alvislin/CortexM3_SoC/AHBlite_ACCC.v

//--------------------------------------------//
// Data   RAM         0   0x40030000          //
// ........                                   //
// Data   RAM         149 0x40030095          //
// STATE              REG 0x40030096          //
// NUM0                   0x40030097          //
// ........                                   //
// NUM0                   0x400300a0          //
//--------------------------------------------//
module AHBlite_ACCC (
    input   wire                        HCLK,    
    input   wire                        HRESETn, 
    input   wire                        HSEL,    
    input   wire    [31:0]              HADDR,   
    input   wire    [1:0]               HTRANS,  
    input   wire    [2:0]               HSIZE,   
    input   wire    [3:0]               HPROT,   
    input   wire                        HWRITE,  
    input   wire    [31:0]              HWDATA,   
    input   wire                        HREADY, 
    output  wire                        HREADYOUT, 
    output  wire    [31:0]              HRDATA,  
    output  wire    [1:0]               HRESP,

    input   wire    [5:0]               Data_RAM_RD_Addr,
    output  wire    [23:0]              Data_RAM_RD_Data,

    input   wire    [8:0]               Weight_RAM_RD_Addr,
    output  wire    [191:0]             Weight_RAM_RD_Data,

    input   wire    [7:0]               Num0,
    input   wire    [7:0]               Num1,
    input   wire    [7:0]               Num2,
    input   wire    [7:0]               Num3,
    input   wire    [7:0]               Num4,
    input   wire    [7:0]               Num5,
    input   wire    [7:0]               Num6,
    input   wire    [7:0]               Num7,
    input   wire    [7:0]               Num8,
    input   wire    [7:0]               Num9,

    output  wire                        ACC_VALID,
    input   wire                        ACC_READY
);

//--------------------------------------------------
// RAM
//--------------------------------------------------

reg     [5:0]   Data_RAM_WR_Addr;
wire    [7:0]   Data_RAM_WR_Data;
wire    [2:0]   Data_RAM_WE_T;

LocalRAM #(
    .ByteWidth      (3),
    .AddrWidth      (6)
)   Data_RAM(
    .clk        (HCLK),
    .din        (Data_RAM_WR_Data),
    .rdaddr     (Data_RAM_RD_Addr),
    .we         (Data_RAM_WE_T),
    .wraddr     (Data_RAM_WR_Addr),
    .dout       (Data_RAM_RD_Data)
);

LocalROM #(
    .ByteWidth      (24),
    .AddrWidth      (9)
)   Weight_RAM(
    .clk        (HCLK),
    .addr       (Weight_RAM_RD_Addr),
    .dout       (Weight_RAM_RD_Data)
);

//--------------------------------------------------
// AHB SIGNALS
//--------------------------------------------------

assign HRESP        = 2'b0;
assign HREADYOUT    = 1'b1;

wire trans_en;
assign trans_en     = HSEL & HTRANS[1] & HREADY;

wire write_en;
assign write_en     = trans_en & HWRITE;


reg wr_en_reg;
always@(posedge HCLK or negedge HRESETn) begin
  if(~HRESETn) 
    wr_en_reg <= 1'b0;
  else 
    wr_en_reg <= write_en;
end

reg [7:0] addr_reg;
always@(posedge HCLK or negedge HRESETn) begin
  if(~HRESETn) 
    addr_reg <= 4'b0;
  else if(trans_en) 
    addr_reg <= HADDR[7:0];
end

//--------------------------------------------------
// STATE CONTROL
//--------------------------------------------------

reg state;
wire state_nxt;

assign state_en     = wr_en_reg &   (addr_reg == 8'h96) & HWDATA[0];
assign state_nxt    = state     ?   (~ACC_READY)    :   state_en;

always@(posedge HCLK or negedge HRESETn) begin
  if(~HRESETn) 
    state <= 1'b0;
  else 
    state <= state_nxt;
end

assign  ACC_VALID   =   state;

//--------------------------------------------------
// DATA RAM CONTROL
//--------------------------------------------------

// assign  Data_RAM_WE         =   wr_en_reg   &   (addr_reg == 4'h0);
// assign  Data_RAM_WR_Addr    =   HWDATA[29:24];
assign  Data_RAM_WR_Data    =   HWDATA[7:0];

reg     [2:0]   Data_RAM_WE;

assign  Data_RAM_WE_T = wr_en_reg ? Data_RAM_WE : 3'h0;

always@(*) begin
  case(addr_reg)
    8'h00 : begin
      Data_RAM_WE = 3'h1;
      Data_RAM_WR_Addr = 6'h00;
    end 8'h1 : begin
      Data_RAM_WR_Addr = 6'h0;
      Data_RAM_WE = 3'h2;
    end 8'h2 : begin
      Data_RAM_WR_Addr = 6'h0;
      Data_RAM_WE = 3'h4;
    end 8'h3 : begin
      Data_RAM_WR_Addr = 6'h1;
      Data_RAM_WE = 3'h1;
    end 8'h4 : begin
      Data_RAM_WR_Addr = 6'h1;
      Data_RAM_WE = 3'h2;
    end 8'h5 : begin
      Data_RAM_WR_Addr = 6'h1;
      Data_RAM_WE = 3'h4;
    end 8'h6 : begin
      Data_RAM_WR_Addr = 6'h2;
      Data_RAM_WE = 3'h1;
    end 8'h7 : begin
      Data_RAM_WR_Addr = 6'h2;
      Data_RAM_WE = 3'h2;
    end 8'h8 : begin
      Data_RAM_WR_Addr = 6'h2;
      Data_RAM_WE = 3'h4;
    end 8'h9 : begin
      Data_RAM_WR_Addr = 6'h3;
      Data_RAM_WE = 3'h1;
    end 8'ha : begin
      Data_RAM_WR_Addr = 6'h3;
      Data_RAM_WE = 3'h2;
    end 8'hb : begin
      Data_RAM_WR_Addr = 6'h3;
      Data_RAM_WE = 3'h4;
    end 8'hc : begin
      Data_RAM_WR_Addr = 6'h4;
      Data_RAM_WE = 3'h1;
    end 8'hd : begin
      Data_RAM_WR_Addr = 6'h4;
      Data_RAM_WE = 3'h2;
    end 8'he : begin
      Data_RAM_WR_Addr = 6'h4;
      Data_RAM_WE = 3'h4;
    end 8'hf : begin
      Data_RAM_WR_Addr = 6'h5;
      Data_RAM_WE = 3'h1;
    end 8'h10 : begin
      Data_RAM_WR_Addr = 6'h5;
      Data_RAM_WE = 3'h2;
    end 8'h11 : begin
      Data_RAM_WR_Addr = 6'h5;
      Data_RAM_WE = 3'h4;
    end 8'h12 : begin
      Data_RAM_WR_Addr = 6'h6;
      Data_RAM_WE = 3'h1;
    end 8'h13 : begin
      Data_RAM_WR_Addr = 6'h6;
      Data_RAM_WE = 3'h2;
    end 8'h14 : begin
      Data_RAM_WR_Addr = 6'h6;
      Data_RAM_WE = 3'h4;
    end 8'h15 : begin
      Data_RAM_WR_Addr = 6'h7;
      Data_RAM_WE = 3'h1;
    end 8'h16 : begin
      Data_RAM_WR_Addr = 6'h7;
      Data_RAM_WE = 3'h2;
    end 8'h17 : begin
      Data_RAM_WR_Addr = 6'h7;
      Data_RAM_WE = 3'h4;
    end 8'h18 : begin
      Data_RAM_WR_Addr = 6'h8;
      Data_RAM_WE = 3'h1;
    end 8'h19 : begin
      Data_RAM_WR_Addr = 6'h8;
      Data_RAM_WE = 3'h2;
    end 8'h1a : begin
      Data_RAM_WR_Addr = 6'h8;
      Data_RAM_WE = 3'h4;
    end 8'h1b : begin
      Data_RAM_WR_Addr = 6'h9;
      Data_RAM_WE = 3'h1;
    end 8'h1c : begin
      Data_RAM_WR_Addr = 6'h9;
      Data_RAM_WE = 3'h2;
    end 8'h1d : begin
      Data_RAM_WR_Addr = 6'h9;
      Data_RAM_WE = 3'h4;
    end 8'h1e : begin
      Data_RAM_WR_Addr = 6'ha;
      Data_RAM_WE = 3'h1;
    end 8'h1f : begin
      Data_RAM_WR_Addr = 6'ha;
      Data_RAM_WE = 3'h2;
    end 8'h20 : begin
      Data_RAM_WR_Addr = 6'ha;
      Data_RAM_WE = 3'h4;
    end 8'h21 : begin
      Data_RAM_WR_Addr = 6'hb;
      Data_RAM_WE = 3'h1;
    end 8'h22 : begin
      Data_RAM_WR_Addr = 6'hb;
      Data_RAM_WE = 3'h2;
    end 8'h23 : begin
      Data_RAM_WR_Addr = 6'hb;
      Data_RAM_WE = 3'h4;
    end 8'h24 : begin
      Data_RAM_WR_Addr = 6'hc;
      Data_RAM_WE = 3'h1;
    end 8'h25 : begin
      Data_RAM_WR_Addr = 6'hc;
      Data_RAM_WE = 3'h2;
    end 8'h26 : begin
      Data_RAM_WR_Addr = 6'hc;
      Data_RAM_WE = 3'h4;
    end 8'h27 : begin
      Data_RAM_WR_Addr = 6'hd;
      Data_RAM_WE = 3'h1;
    end 8'h28 : begin
      Data_RAM_WR_Addr = 6'hd;
      Data_RAM_WE = 3'h2;
    end 8'h29 : begin
      Data_RAM_WR_Addr = 6'hd;
      Data_RAM_WE = 3'h4;
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
    end 8'h84 : begin
      Data_RAM_WR_Addr = 6'h2c;
      Data_RAM_WE = 3'h1;
    end 8'h85 : begin
      Data_RAM_WR_Addr = 6'h2c;
      Data_RAM_WE = 3'h2;
    end 8'h86 : begin
      Data_RAM_WR_Addr = 6'h2c;
      Data_RAM_WE = 3'h4;
    end 8'h87 : begin
      Data_RAM_WR_Addr = 6'h2d;
      Data_RAM_WE = 3'h1;
    end 8'h88 : begin
      Data_RAM_WR_Addr = 6'h2d;
      Data_RAM_WE = 3'h2;
    end 8'h89 : begin
      Data_RAM_WR_Addr = 6'h2d;
      Data_RAM_WE = 3'h4;
    end 8'h8a : begin
      Data_RAM_WR_Addr = 6'h2e;
      Data_RAM_WE = 3'h1;
    end 8'h8b : begin
      Data_RAM_WR_Addr = 6'h2e;
      Data_RAM_WE = 3'h2;
    end 8'h8c : begin
      Data_RAM_WR_Addr = 6'h2e;
      Data_RAM_WE = 3'h4;
    end 8'h8d : begin
      Data_RAM_WR_Addr = 6'h2f;
      Data_RAM_WE = 3'h1;
    end 8'h8e : begin
      Data_RAM_WR_Addr = 6'h2f;
      Data_RAM_WE = 3'h2;
    end 8'h8f : begin
      Data_RAM_WR_Addr = 6'h2f;
      Data_RAM_WE = 3'h4;
    end 8'h90 : begin
      Data_RAM_WR_Addr = 6'h30;
      Data_RAM_WE = 3'h1;
    end 8'h91 : begin
      Data_RAM_WR_Addr = 6'h30;
      Data_RAM_WE = 3'h2;
    end 8'h92 : begin
      Data_RAM_WR_Addr = 6'h30;
      Data_RAM_WE = 3'h4;
    end 8'h93 : begin
      Data_RAM_WR_Addr = 6'h31;
      Data_RAM_WE = 3'h1;
    end 8'h94 : begin
      Data_RAM_WR_Addr = 6'h31;
      Data_RAM_WE = 3'h2;
    end 8'h95 : begin
      Data_RAM_WR_Addr = 6'h31;
      Data_RAM_WE = 3'h4;
    end default : begin
      Data_RAM_WE = 3'h0;
      Data_RAM_WR_Addr = 6'h00;
    end
  endcase
end

//--------------------------------------------------
// READ OUT
//--------------------------------------------------

assign  HRDATA  =   (addr_reg   ==  8'h96)   ?   {4{7'b0,state}}:   (
                    (addr_reg   ==  8'h97)   ?   {4{Num0}}      :   (
                    (addr_reg   ==  8'h98)   ?   {4{Num1}}      :   (
                    (addr_reg   ==  8'h99)   ?   {4{Num2}}      :   (
                    (addr_reg   ==  8'h9a)   ?   {4{Num3}}      :   (
                    (addr_reg   ==  8'h9b)   ?   {4{Num4}}      :   (
                    (addr_reg   ==  8'h9c)   ?   {4{Num5}}      :   (
                    (addr_reg   ==  8'h9d)   ?   {4{Num6}}      :   (
                    (addr_reg   ==  8'h9e)   ?   {4{Num7}}      :   (
                    (addr_reg   ==  8'h9f)   ?   {4{Num8}}      :   (
                    (addr_reg   ==  8'ha0)   ?   {4{Num9}}      :   32'b0))))))))));



endmodule
