alvislin/CortexM3_SoC/ConvLayer.v

//-------------------------------------------------------------------
//	2019 8 1
//	HAVE DONE:
//		Pipline & FSM
//		Standardized Coding
//	NEED DO:
//		Simulation
//------------------------------------------------------------------

module ConvLayer(

    // Sys Signals
    input   wire            clk,
    input   wire            rstn,

	// CONV LAYER 1 HANDSHAKE
    input   wire            L1ConvValid_i,
    output  wire            L1ConvReady_o,

	// CONV LAYER 2 HANDSHAKE
    input   wire            L2ConvValid_i,
    output  wire            L2ConvReady_o,

    // Input Data Signals
    output  wire    [5:0]   DataRamAddr_o,
    input   wire    [23:0]  DataRamData_i,

    // Input Weight Signals

    output  wire    [8:0]   WtRamAddr_o,
    input   wire    [191:0] WtRamData_i,

    // Output Mem Signals

    output  wire            OutChan0We_o,  
    output  wire            OutChan1We_o,
    output  wire            OutChan2We_o,
    output  wire            OutChan3We_o,
    output  wire            OutChan4We_o,
    output  wire            OutChan5We_o,
    output  wire            OutChan6We_o,
    output  wire            OutChan7We_o,
    output  wire    [3:0]   OutChanAddr_o,
    output  wire    [47:0]  OutChanData_o
);

localparam 		L1InBP	= 6;
localparam 		L1WtBP	= 7;
localparam		L1OutBP	= 4;
localparam 		L2InBP	= 4;
localparam 		L2WtBP	= 7;
localparam		L2OutBP	= 2;


localparam		L1Conv0Bias = 19'b00000_00010011_000000;
localparam		L1Conv1Bias = 19'b00000_00110001_000000;
localparam		L1Conv2Bias = 19'b00000_00001001_000000;
localparam		L1Conv3Bias = 19'b00000_00100010_000000;
localparam		L1Conv4Bias = 19'b00000_00010011_000000;
localparam		L1Conv5Bias = 19'b00000_00100100_000000;
localparam		L1Conv6Bias = 19'b00000_00010110_000000;
localparam		L1Conv7Bias = 19'b00000_00001100_000000;

localparam		L2Conv0Bias = 22'b0000000000_00001101_0000;
localparam		L2Conv1Bias = 22'b0000000000_00001101_0000;
localparam		L2Conv2Bias = 22'b0000000000_00001101_0000;
localparam		L2Conv3Bias = 22'b0000000000_00011001_0000;
localparam		L2Conv4Bias = 22'b0000000000_00001111_0000;
localparam		L2Conv5Bias = 22'b0000000000_00010000_0000;
localparam		L2Conv6Bias = 22'b0000000000_00001100_0000;
localparam		L2Conv7Bias = 22'b0000000000_00001101_0000;

wire            ConvLayerSel;

//-----------------------------------------------------
//  LOCAL RAM
//-----------------------------------------------------

wire    [95:0]  Ram0WrData;    
wire    [95:0]  Ram1WrData;  
wire    [95:0]  Ram2WrData;  
wire    [95:0]  Ram3WrData;  
wire    [95:0]  Ram4WrData;  
wire    [95:0]  Ram5WrData;  
wire    [95:0]  Ram6WrData;  
wire    [95:0]  Ram7WrData;  

wire    [95:0]  Ram0RdData;    
wire    [95:0]  Ram1RdData;  
wire    [95:0]  Ram2RdData;  
wire    [95:0]  Ram3RdData;  
wire    [95:0]  Ram4RdData;  
wire    [95:0]  Ram5RdData;  
wire    [95:0]  Ram6RdData;  
wire    [95:0]  Ram7RdData;  

wire    [4:0]   RamRdAddr;
wire    [4:0]   RamWrAddr;
wire            RamWrEn;

L1RAM Chan0(
	.clock      			(clk),
	.data       			(Ram0WrData),
	.rdaddress  			(RamRdAddr),
	.wraddress  			(RamWrAddr),
	.wren       			(RamWrEn),
	.q       				(Ram0RdData)
);

L1RAM Chan1(
	.clock      			(clk),
	.data       			(Ram1WrData),
	.rdaddress  			(RamRdAddr),
	.wraddress  			(RamWrAddr),
	.wren       			(RamWrEn),
	.q       				(Ram1RdData)
);

L1RAM Chan2(
	.clock      			(clk),
	.data       			(Ram2WrData),
	.rdaddress  			(RamRdAddr),
	.wraddress  			(RamWrAddr),
	.wren       			(RamWrEn),
	.q       				(Ram2RdData)
);

L1RAM Chan3(
	.clock      			(clk),
	.data       			(Ram3WrData),
	.rdaddress  			(RamRdAddr),
	.wraddress  			(RamWrAddr),
	.wren       			(RamWrEn),
	.q       				(Ram3RdData)
);

L1RAM Chan4(
	.clock      			(clk),
	.data       			(Ram4WrData),
	.rdaddress  			(RamRdAddr),
	.wraddress  			(RamWrAddr),
	.wren       			(RamWrEn),
	.q       				(Ram4RdData)
);

L1RAM Chan5(
	.clock      			(clk),
	.data       			(Ram5WrData),
	.rdaddress  			(RamRdAddr),
	.wraddress  			(RamWrAddr),
	.wren       			(RamWrEn),
	.q       				(Ram5RdData)
);

L1RAM Chan6(
	.clock      			(clk),
	.data       			(Ram6WrData),
	.rdaddress  			(RamRdAddr),
	.wraddress  			(RamWrAddr),
	.wren       			(RamWrEn),
	.q       				(Ram6RdData)
);

L1RAM Chan7(
	.clock      			(clk),
	.data       			(Ram7WrData),
	.rdaddress  			(RamRdAddr),
	.wraddress  			(RamWrAddr),
	.wren       			(RamWrEn),
	.q       				(Ram7RdData)
);


//-----------------------------------------------------
//  WEIGHT BUFFER
//-----------------------------------------------------

wire    [191:0]     WtWinConvLine0;
wire    [191:0]     WtWinConvLine1;
wire                WtBufEn;

InputBuffer #(
    .Width                  (192)
)   WtBuf(
    .clk                    (clk),
    .rstn                   (rstn),
    .din                    (WtRamData_i),
    .en                     (WtBufEn),
	.zero					(1'b0),
    .dout0                  (WtWinConvLine0),
    .dout1                  (WtWinConvLine1)
);

//-----------------------------------------------------
//  CONV L1 INPUT BUFFER & PIXEL DECODER
//-----------------------------------------------------

wire    [23:0]   L1Buf0;
wire    [23:0]   L1Buf1;

wire             L1InBufEn;
wire		     L1InBufZero;
wire			 L1WinMuxZero;

InputBuffer #(
    .Width      			(24)
)   L1InBuf (
    .clk        			(clk),
    .rstn       			(rstn),
    .din        			(DataRamData_i),
    .en         			(L1InBufEn),
	.zero					(L1InBufZero),
    .dout0      			(L1Buf0),
    .dout1      			(L1Buf1)
);

wire    [23:0]  L1DataWinConvLine0;
wire    [23:0]  L1DataWinConvLine1;
wire    [23:0]  L1DataWinConvLine2;
wire    [4:0]   L1ConvWinCnt;

PixelDecoder #(
	.BP						(L1InBP)
)	PxDec(
    .LineIn0    			(L1Buf0),
    .LineIn1    			(L1Buf1),
    .LineIn2    			(DataRamData_i),
    .Sel        			(L1ConvWinCnt),
	.Zero					(L1WinMuxZero),
    .LineOut0   			(L1DataWinConvLine0),
    .LineOut1   			(L1DataWinConvLine1),
    .LineOut2   			(L1DataWinConvLine2)
);

//-----------------------------------------------------
//  CONV L2 INPUT BUFFER & MUX
//-----------------------------------------------------

wire    [95:0]   L2Conv0Buf0;
wire    [95:0]   L2Conv0Buf1;
wire    [95:0]   L2Conv1Buf0;
wire    [95:0]   L2Conv1Buf1;
wire    [95:0]   L2Conv2Buf0;
wire    [95:0]   L2Conv2Buf1;
wire    [95:0]   L2Conv3Buf0;
wire    [95:0]   L2Conv3Buf1;
wire    [95:0]   L2Conv4Buf0;
wire    [95:0]   L2Conv4Buf1;
wire    [95:0]   L2Conv5Buf0;
wire    [95:0]   L2Conv5Buf1;
wire    [95:0]   L2Conv6Buf0;
wire    [95:0]   L2Conv6Buf1;
wire    [95:0]   L2Conv7Buf0;
wire    [95:0]   L2Conv7Buf1;

wire             L2InBufEn;
wire			 L2InBufZero;

InputBuffer #(
	.Width      			(96)
)   L2InBuf0 (
	.clk        			(clk),
	.rstn       			(rstn),
	.din        			(Ram0RdData),
	.en         			(L2InBufEn),
	.zero					(L2InBufZero),
	.dout0      			(L2Conv0Buf0),
	.dout1      			(L2Conv0Buf1)
);

InputBuffer #(
	.Width      			(96)
)   L2InBuf1 (
	.clk        			(clk),
	.rstn       			(rstn),
	.din        			(Ram1RdData),
	.en         			(L2InBufEn),
	.zero					(L2InBufZero),
	.dout0      			(L2Conv1Buf0),
	.dout1      			(L2Conv1Buf1)
);

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
);

WinMux   WM6(
	.LineIn0    			(L2Conv6Buf0),
	.LineIn1    			(L2Conv6Buf1),
	.LineIn2    			(Ram6RdData),
	.Sel        			(L2ConvWinCnt),
	.Zero					(L2WinMuxZero),
	.LineOut0   			(L2DataWinConv6Line0),
	.LineOut1   			(L2DataWinConv6Line1),
	.LineOut2   			(L2DataWinConv6Line2)
);

WinMux   WM7(
	.LineIn0    			(L2Conv7Buf0),
	.LineIn1    			(L2Conv7Buf1),
	.LineIn2    			(Ram7RdData),
	.Sel        			(L2ConvWinCnt),
	.Zero					(L2WinMuxZero),
	.LineOut0   			(L2DataWinConv7Line0),
	.LineOut1   			(L2DataWinConv7Line1),
	.LineOut2   			(L2DataWinConv7Line2)
);

//-----------------------------------------------------
//  CONV INPUT CONTROLER
//-----------------------------------------------------

wire    [8:0]   L1WtRamAddr;
wire    [8:0]   L2WtRamAddr;
wire			L1ConvInVbit;
wire			L2ConvInVbit;
wire			L1WtBufEn;
wire			L2WtBufEn;

L1ConvInCtrl L1CIC(
	.clk                    (clk),
    .rstn                   (rstn),
    .ConvValid_i            (L1ConvValid_i),
    .DataRamAddr_o        	(DataRamAddr_o),
    .WtRamAddr_o	        (L1WtRamAddr),
    .InBufEn_o              (L1InBufEn),
	.InBufZero_o			(L1InBufZero),
	.WinMuxZero_o			(L1WinMuxZero),
    .WtBufEn_o           	(L1WtBufEn),
    .ConvWinCnt_o           (L1ConvWinCnt),
	.vbit_o					(L1ConvInVbit)
);

L2ConvInCtrl L2CIC(
    .clk                    (clk),
    .rstn                   (rstn),
    .ConvValid_i            (L2ConvValid_i),
    .DataRamAddr_o	        (RamRdAddr),
    .WtRamAddr_o	        (L2WtRamAddr),
    .WtBufEn_o           	(L2WtBufEn),
    .InBufEn_o              (L2InBufEn),
	.InBufZero_o			(L2InBufZero),
	.WinMuxZero_o			(L2WinMuxZero),
    .ConvWinCnt		        (L2ConvWinCnt),
    .ConvSel                (ConvLayerSel),
	.vbit_o					(L2ConvInVbit)
);

assign  WtRamAddr_o	= ConvLayerSel	? L2WtRamAddr : L1WtRamAddr;
assign  WtBufEn	= L1WtBufEn 	| L2WtBufEn;


//-----------------------------------------------------
//  CONV INPUT MUX
//-----------------------------------------------------

wire    [23:0]   DataWinConv0Line0;
wire    [23:0]   DataWinConv0Line1;
wire    [23:0]   DataWinConv0Line2;
wire    [23:0]   DataWinConv1Line0;
wire    [23:0]   DataWinConv1Line1;
wire    [23:0]   DataWinConv1Line2;
wire    [23:0]   DataWinConv2Line0;
wire    [23:0]   DataWinConv2Line1;
wire    [23:0]   DataWinConv2Line2;
wire    [23:0]   DataWinConv3Line0;
wire    [23:0]   DataWinConv3Line1;
wire    [23:0]   DataWinConv3Line2;
wire    [23:0]   DataWinConv4Line0;
wire    [23:0]   DataWinConv4Line1;
wire    [23:0]   DataWinConv4Line2;
wire    [23:0]   DataWinConv5Line0;
wire    [23:0]   DataWinConv5Line1;
wire    [23:0]   DataWinConv5Line2;
wire    [23:0]   DataWinConv6Line0;
wire    [23:0]   DataWinConv6Line1;
wire    [23:0]   DataWinConv6Line2;
wire    [23:0]   DataWinConv7Line0;
wire    [23:0]   DataWinConv7Line1;
wire    [23:0]   DataWinConv7Line2;

Two2OneMux #(
	.Width      			(24)
)   C0L0MUX(
	.din0       			(L1DataWinConvLine0),
	.din1       			(L2DataWinConv0Line0),
	.sel        			(ConvLayerSel),
	.dout       			(DataWinConv0Line0)
);

Two2OneMux #(
	.Width      			(24)
)   C0L1MUX(
	.din0       			(L1DataWinConvLine1),
	.din1       			(L2DataWinConv0Line1),
	.sel        			(ConvLayerSel),
	.dout       			(DataWinConv0Line1)
);

Two2OneMux #(
	.Width      			(24)
)   C0L2MUX(
	.din0       			(L1DataWinConvLine2),
	.din1       			(L2DataWinConv0Line2),
	.sel        			(ConvLayerSel),
	.dout       			(DataWinConv0Line2)
);

Two2OneMux #(
	.Width      			(24)
)   C1L0MUX(
	.din0       			(L1DataWinConvLine0),
	.din1       			(L2DataWinConv1Line0),
	.sel        			(ConvLayerSel),
	.dout       			(DataWinConv1Line0)
);

Two2OneMux #(
	.Width      			(24)
)   C1L1MUX(
	.din0       			(L1DataWinConvLine1),
	.din1       			(L2DataWinConv1Line1),
	.sel        			(ConvLayerSel),
	.dout       			(DataWinConv1Line1)
);

Two2OneMux #(
	.Width      			(24)
)   C1L2MUX(
	.din0       			(L1DataWinConvLine2),
	.din1       			(L2DataWinConv1Line2),
	.sel        			(ConvLayerSel),
	.dout       			(DataWinConv1Line2)
);

Two2OneMux #(
	.Width      			(24)
)   C2L0MUX(
	.din0       			(L1DataWinConvLine0),
	.din1       			(L2DataWinConv2Line0),
	.sel        			(ConvLayerSel),
	.dout       			(DataWinConv2Line0)
);

Two2OneMux #(
	.Width      			(24)
)   C2L1MUX(
	.din0       			(L1DataWinConvLine1),
	.din1       			(L2DataWinConv2Line1),
	.sel        			(ConvLayerSel),
	.dout       			(DataWinConv2Line1)
);

Two2OneMux #(
	.Width      			(24)
)   C2L2MUX(
	.din0       			(L1DataWinConvLine2),
	.din1       			(L2DataWinConv2Line2),
	.sel        			(ConvLayerSel),
	.dout       			(DataWinConv2Line2)
);

Two2OneMux #(
	.Width      			(24)
)   C3L0MUX(
	.din0       			(L1DataWinConvLine0),
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
	.L2Conv1Bias			(L2Conv1Bias),
	.L2Conv2Bias			(L2Conv2Bias),
	.L2Conv3Bias			(L2Conv3Bias),
	.L2Conv4Bias			(L2Conv4Bias),
	.L2Conv5Bias			(L2Conv5Bias),
	.L2Conv6Bias			(L2Conv6Bias),
	.L2Conv7Bias			(L2Conv7Bias)
)	BM(
	.Sel_i					(L2BiasSel),
	.Bias_o					(L2ConvBias)
);

FixPointAdder #(
    .Width(22)
)   L2Final(
    .dina   				(L2ConvATOut),
    .dinb   				(L2Conv0Bias),
    .dout   				(L2BeforeReLU)
);

wire    [22:0]  L2AfterReLU;

ReLU #(
    .Width  (23)
)    L2relu(
    .din    				(L2BeforeReLU),
    .dout   				(L2AfterReLU)
);

wire    [7:0]   L2AfterAlign;

Align #(
    .Width      			(23),
    .BP_S0      			(L2InBP),
    .BP_S1      			(L2WtBP),
    .BP_D       			(L2OutBP)
)   L2A(
    .din        			(L2AfterReLU),
    .dout       			(L2AfterAlign)
);

//-----------------------------------------------------
//  CONV RS CONTROLER
//-----------------------------------------------------

wire    L1ConvPoolLine0We;
wire    L1ConvPoolLine1We;
wire    [4:0] L1ConvPoolLineSel;

wire    L2ConvPoolLine0We;
wire    L2ConvPoolLine1We;
wire    [3:0] L2ConvPoolLineSel;

wire	L2RsZero;

wire	L1RsOutVbit;
wire	L2RsOutVbit;

L1RsCtrl L1RC(
	.clk					(clk),
	.rstn					(rstn),
	.ConvValid_i			(L1ConvValid_i),
	.vbit_i					(ConvOutVbit),
	.PoolLineSel_o			(L1ConvPoolLineSel),
	.PoolLine0We_o			(L1ConvPoolLine0We),
	.PoolLine1We_o			(L1ConvPoolLine1We),
	.vbit_o					(L1RsOutVbit)
);

L2RsCtrl L2RC(
	.clk					(clk),
	.rstn					(rstn),
	.ConvValid_i			(L2ConvValid_i),
	.vbit_i					(ATOutVbit),
	.RsZero_o				(L2RsZero),
	.PoolLineSel_o			(L2ConvPoolLineSel),
	.PoolLine0We_o			(L2ConvPoolLine0We),
	.PoolLine1We_o			(L2ConvPoolLine1We),
	.vbit_o					(L2RsOutVbit)
);

//-----------------------------------------------------
//  CONV POOL LINE REG
//-----------------------------------------------------

wire    [191:0] L1Conv0PoolLine0;
wire    [191:0] L1Conv0PoolLine1;
wire    [191:0] L1Conv1PoolLine0;
wire    [191:0] L1Conv1PoolLine1;
wire    [191:0] L1Conv2PoolLine0;
wire    [191:0] L1Conv2PoolLine1;
wire    [191:0] L1Conv3PoolLine0;
wire    [191:0] L1Conv3PoolLine1;
wire    [191:0] L1Conv4PoolLine0;
wire    [191:0] L1Conv4PoolLine1;
wire    [191:0] L1Conv5PoolLine0;
wire    [191:0] L1Conv5PoolLine1;
wire    [191:0] L1Conv6PoolLine0;
wire    [191:0] L1Conv6PoolLine1;
wire    [191:0] L1Conv7PoolLine0;
wire    [191:0] L1Conv7PoolLine1;

wire    [95:0] L2ConvPoolLine0;
wire    [95:0] L2ConvPoolLine1;

L1RegSplice   L1Conv0PoolLine0RS(
	.clk        			(clk),
	.rstn       			(rstn),
	.din        			(L1Conv0AfterAlign),
	.Sel        			(L1ConvPoolLineSel),
	.We         			(L1ConvPoolLine0We),
	.dout       			(L1Conv0PoolLine0)
);	

L1RegSplice   L1Conv0PoolLine1RS(
	.clk        			(clk),
	.rstn       			(rstn),
	.din        			(L1Conv0AfterAlign),
	.Sel        			(L1ConvPoolLineSel),
	.We         			(L1ConvPoolLine1We),
	.dout       			(L1Conv0PoolLine1)
);

L1RegSplice   L1Conv1PoolLine0RS(
	.clk        			(clk),
	.rstn       			(rstn),
	.din        			(L1Conv1AfterAlign),
	.Sel        			(L1ConvPoolLineSel),
	.We         			(L1ConvPoolLine0We),
	.dout       			(L1Conv1PoolLine0)
);

L1RegSplice   L1Conv1PoolLine1RS(
	.clk        			(clk),
	.rstn       			(rstn),
	.din        			(L1Conv1AfterAlign),
	.Sel        			(L1ConvPoolLineSel),
	.We         			(L1ConvPoolLine1We),
	.dout       			(L1Conv1PoolLine1)
);

L1RegSplice   L1Conv2PoolLine0RS(
	.clk        			(clk),
	.rstn       			(rstn),
	.din        			(L1Conv2AfterAlign),
	.Sel        			(L1ConvPoolLineSel),
	.We         			(L1ConvPoolLine0We),
	.dout       			(L1Conv2PoolLine0)
);

L1RegSplice   L1Conv2PoolLine1RS(
	.clk        			(clk),
	.rstn       			(rstn),
	.din        			(L1Conv2AfterAlign),
	.Sel        			(L1ConvPoolLineSel),
	.We         			(L1ConvPoolLine1We),
	.dout       			(L1Conv2PoolLine1)
);

L1RegSplice   L1Conv3PoolLine0RS(
	.clk        			(clk),
	.rstn       			(rstn),
	.din        			(L1Conv3AfterAlign),
	.Sel        			(L1ConvPoolLineSel),
	.We         			(L1ConvPoolLine0We),
	.dout       			(L1Conv3PoolLine0)
);

L1RegSplice   L1Conv3PoolLine1RS(
	.clk        			(clk),
	.rstn       			(rstn),
	.din        			(L1Conv3AfterAlign),
	.Sel        			(L1ConvPoolLineSel),
	.We         			(L1ConvPoolLine1We),
	.dout       			(L1Conv3PoolLine1)
);

L1RegSplice   L1Conv4PoolLine0RS(
	.clk        			(clk),
	.rstn       			(rstn),
	.din        			(L1Conv4AfterAlign),
	.Sel        			(L1ConvPoolLineSel),
	.We         			(L1ConvPoolLine0We),
	.dout       			(L1Conv4PoolLine0)
);

L1RegSplice   L1Conv4PoolLine1RS(
	.clk        			(clk),
	.rstn       			(rstn),
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
	.OutputLocalRAM2We_o	(OutChan2We_o),
	.OutputLocalRAM3We_o	(OutChan3We_o),
	.OutputLocalRAM4We_o	(OutChan4We_o),
	.OutputLocalRAM5We_o	(OutChan5We_o),
	.OutputLocalRAM6We_o	(OutChan6We_o),
	.OutputLocalRAM7We_o	(OutChan7We_o),
	.ConvReady_o			(L2ConvReady_o)
);

endmodule
