alvislin/CortexM3_SoC/SOFTWARE/camera_initial_reg_file.h

#include <stdint.h>

const uint8_t camera_initial_reg[][3] = {
    
    0x31,0x03,0x11,// PCLK from pad
	0x30,0x08,0x82,// Software reset

	0x30,0x08,0x42,// Software power down
	0x31,0x03,0x03,// PCLK from PLL bit[1]:0:pad 1:pll

	0x30,0x17,0xff,// Set D output
	0x30,0x18,0xff,// 

	0x30,0x34,0x1A,// 10BIT MIPI MODE
    0x30,0x37,0x03,// PLL PRE-DIVIDER 3 ROOT-DIVIDER 2
	0x31,0x08,0x01,// SCLK = pll_clki/2 || SCLK2x = pll_clki || PCLK = pll_clki 

	0x36,0x30,0x36,
	0x36,0x31,0x0e,
	0x36,0x32,0xe2,
	0x36,0x33,0x12,
	0x36,0x21,0xe0,
	0x37,0x04,0xa0,
	0x37,0x03,0x5a,
	0x37,0x15,0x78,
	0x37,0x17,0x01,
	0x37,0x0b,0x60,
	0x37,0x05,0x1a,
	0x39,0x05,0x02,
	0x39,0x06,0x10,
	0x39,0x01,0x0a,
	0x37,0x31,0x12,

	0x36,0x00,0x08,// debug mode
	0x36,0x01,0x33,

	0x30,0x2d,0x60,
	0x36,0x20,0x52,
	0x37,0x1b,0x20,
	0x47,0x1c,0x50,

	0x3a,0x13,0x43,// pre-gain enable pre-gain = 3
	0x3a,0x18,0x00,
	0x3a,0x19,0xf8,// AEC gain 0xf8
	0x36,0x35,0x13,
	0x36,0x36,0x03,
	0x36,0x34,0x40,
	0x36,0x22,0x01,

    // 50/60 hz detection
	0x3c,0x01,0x34,
	0x3c,0x04,0x28,
	0x3c,0x05,0x98,
	0x3c,0x06,0x00,
	0x3c,0x07,0x08,
	0x3c,0x08,0x00,
	0x3c,0x09,0x1c,
	0x3c,0x0a,0x9c,
	0x3c,0x0b,0x40,
	0x38,0x10,0x00,
	0x38,0x11,0x10,
	0x38,0x12,0x00,
	0x37,0x08,0x64,
	0x40,0x01,0x02,
	0x40,0x05,0x1a,
	0x30,0x00,0x00,
	0x30,0x04,0xff,
	0x30,0x0e,0x58,
	0x30,0x2e,0x00,

    // RGB 565
	0x43,0x00,0x60,
	0x50,0x1f,0x01,

    // ONONONON
	0x44,0x0e,0x00,
	0x50,0x00,0xa7,

    // AEC TARGET
	0x3a,0x0f,0x30,
	0x3a,0x10,0x28,
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
    0x38,0x0a, 0x00, // DVPVO = 240
    0x38,0x0b, 0xf0, // DVPVO
    0x38,0x10, 0x00, // H offset = 16
    0x38,0x11, 0x10, // H offset
    0x38,0x12, 0x00, // V offset = 4
    0x38,0x13, 0x04, // V offset
    0x32,0x12, 0x13, // end group 3
    0x32,0x12, 0xa3 // launch group 3   
};
