alvislin/CortexM3_SoC/AHBlite_BusMatrix_Decoder_SYS.v

module AHBlite_BusMatrix_Decoder_SYS(

    input   HCLK,
    input   HRESETn,

    //  FROM INPUTSTAGE
    input   HREADY,
    input   [31:0]  HADDR,
    input   [1:0]   HTRANS,

    //  FROM OUTPUTSTAGE
    input   ACTIVE_Outputstage_DTCM,
    input   HREADYOUT_Outputstage_DTCM,
    input   [1:0]   HRESP_DTCM,
    input   [31:0]  HRDATA_DTCM,

    //  FROM OUTPUTSTAGE
    input   ACTIVE_Outputstage_SUB,
    input   HREADYOUT_Outputstage_SUB,
    input   [1:0]   HRESP_SUB,
    input   [31:0]  HRDATA_SUB,

    //  FROM OUTPUTSTAGE
    input   ACTIVE_Outputstage_CAMERA,
    input   HREADYOUT_Outputstage_CAMERA,
    input   [1:0]   HRESP_CAMERA,
    input   [31:0]  HRDATA_CAMERA,

    //  FROM OUTPUTSTAGE
    input   ACTIVE_Outputstage_ACCC,
    input   HREADYOUT_Outputstage_ACCC,
    input   [1:0]   HRESP_ACCC,
    input   [31:0]  HRDATA_ACCC,

    //  OUTPUTSTAGE HSEL
    output  wire    HSEL_Decoder_SYS_DTCM,
    output  wire    HSEL_Decoder_SYS_CAMERA,
    output  wire    HSEL_Decoder_SYS_ACCC,
    output  wire    HSEL_Decoder_SYS_SUB,
    
    //  SELOUTPUT
    output  wire    ACTIVE_Decoder_SYS,
    output  wire    HREADYOUT,
    output  wire    [1:0]   HRESP,
    output  wire    [31:0]  HRDATA 
);

assign  HSEL_Decoder_SYS_DTCM   = (HADDR[31:12]  ==  20'h20000);
assign  HSEL_Decoder_SYS_CAMERA = (HADDR[31:16]  ==  16'h4001);
assign  HSEL_Decoder_SYS_SUB    = (HADDR[31:16]  ==  16'h4000);
assign  HSEL_Decoder_SYS_ACCC   = (HADDR[31:16]  ==  16'h4003);

assign  ACTIVE_Decoder_SYS    = HSEL_Decoder_SYS_DTCM       ?   ACTIVE_Outputstage_DTCM     :
                                (HSEL_Decoder_SYS_CAMERA    ?   ACTIVE_Outputstage_CAMERA   :
                                (HSEL_Decoder_SYS_ACCC       ?   ACTIVE_Outputstage_ACCC      :
                                (HSEL_Decoder_SYS_SUB       ?   ACTIVE_Outputstage_SUB      :   1'b1)));

reg [3:0] sel_reg;

always@(posedge HCLK or negedge HRESETn) begin
    if(~HRESETn)
        sel_reg <=  4'b0;
    else if(HREADY)
        sel_reg <=  {
                     HSEL_Decoder_SYS_SUB,
                     HSEL_Decoder_SYS_DTCM,
                     HSEL_Decoder_SYS_CAMERA,
                     HSEL_Decoder_SYS_ACCC};
end

assign  HREADYOUT   =   (sel_reg    ==  4'b0001)  ?   HREADYOUT_Outputstage_ACCC       :
                        ((sel_reg   ==  4'b0010)  ?   HREADYOUT_Outputstage_CAMERA    :
                        ((sel_reg   ==  4'b0100)  ?   HREADYOUT_Outputstage_DTCM      :
                        ((sel_reg   ==  4'b1000)  ?   HREADYOUT_Outputstage_SUB      :   1'b1)));

assign  HRESP       =   (sel_reg    ==  4'b0001)  ?   HRESP_ACCC       :
                        ((sel_reg   ==  4'b0010)  ?   HRESP_CAMERA    :
                        ((sel_reg   ==  4'b0100)  ?   HRESP_DTCM      :
                        ((sel_reg   ==  4'b1000)  ?   HRESP_SUB      :   2'b00)));
                      
assign  HRDATA      =   (sel_reg    ==  4'b0001)  ?   HRDATA_ACCC       :
                        ((sel_reg   ==  4'b0010)  ?   HRDATA_CAMERA    :
                        ((sel_reg   ==  4'b0100)  ?   HRDATA_DTCM      :
                        ((sel_reg   ==  4'b1000)  ?   HRDATA_SUB      :   32'b0)));

endmodule
