alvislin/CortexM3_SoC/L1RegSplice.v

module L1RegSplice(
    input   wire            clk,
    input   wire            rstn,
    input   wire    [7:0]   din,
    input   wire    [4:0]   Sel,
    input   wire            We,
    output  wire    [191:0] dout
);

reg [7:0] dout_reg0;
reg [7:0] dout_reg1;
reg [7:0] dout_reg2;
reg [7:0] dout_reg3;
reg [7:0] dout_reg4;
reg [7:0] dout_reg5;
reg [7:0] dout_reg6;
reg [7:0] dout_reg7;
reg [7:0] dout_reg8;
reg [7:0] dout_reg9;
reg [7:0] dout_reg10;
reg [7:0] dout_reg11;
reg [7:0] dout_reg12;
reg [7:0] dout_reg13;
reg [7:0] dout_reg14;
reg [7:0] dout_reg15;
reg [7:0] dout_reg16;
reg [7:0] dout_reg17;
reg [7:0] dout_reg18;
reg [7:0] dout_reg19;
reg [7:0] dout_reg20;
reg [7:0] dout_reg21;
reg [7:0] dout_reg22;
reg [7:0] dout_reg23;

always@(posedge clk or negedge rstn) begin
	if(~rstn)
		dout_reg0 <= 8'b0;
	else if(We) begin
		if(Sel == 5'd0)
			dout_reg0 <= din;
	end
end

always@(posedge clk or negedge rstn) begin
	if(~rstn)
		dout_reg1 <= 8'b0;
	else if(We) begin
		if(Sel == 5'd1)
			dout_reg1 <= din;
	end
end

always@(posedge clk or negedge rstn) begin
	if(~rstn)
		dout_reg2 <= 8'b0;
	else if(We) begin
		if(Sel == 5'd2)
			dout_reg2 <= din;
	end
end

always@(posedge clk or negedge rstn) begin
	if(~rstn)
		dout_reg3 <= 8'b0;
	else if(We) begin
		if(Sel == 5'd3)
			dout_reg3 <= din;
	end
end

always@(posedge clk or negedge rstn) begin
	if(~rstn)
		dout_reg4 <= 8'b0;
	else if(We) begin
		if(Sel == 5'd4)
			dout_reg4 <= din;
	end
end

always@(posedge clk or negedge rstn) begin
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
			   dout_reg17,  dout_reg16, dout_reg15,  dout_reg14, dout_reg13, dout_reg12,
			   dout_reg11,  dout_reg10, dout_reg9,   dout_reg8,  dout_reg7,  dout_reg6,  
			   dout_reg5,  dout_reg4,   dout_reg3,   dout_reg2,  dout_reg1,  dout_reg0};

endmodule
