alvislin/CortexM3_SoC/Block_RAM.v

module Block_RAM #(
    parameter ADDR_WIDTH = 14)(
    input clka,
    input [ADDR_WIDTH-1:0] addra,
    input [ADDR_WIDTH-1:0] addrb,
    input [31:0] dina,
    input [3:0] wea,
    output wire [31:0] doutb
);

(* ramstyle = "AUTO" *) reg [31:0] mem [(2**ADDR_WIDTH-1):0];

always@(posedge clka) begin
    if(wea[0]) mem[addra][7:0] <= dina[7:0];
end
always@(posedge clka) begin
    if(wea[1]) mem[addra][15:8] <= dina[15:8];
end
always@(posedge clka) begin
    if(wea[2]) mem[addra][23:16] <= dina[23:16];
end
always@(posedge clka) begin
    if(wea[3]) mem[addra][31:24] <= dina[31:24];
end

reg [ADDR_WIDTH-1:0] addrb_reg;

always@(posedge clka) begin
    addrb_reg   <=  addrb;
end

assign doutb = mem[addrb_reg];

endmodule
